eSpark-Consulting-Group/matthewgraff-arduinomegapcb/Design Files/Mega2560_Custom_v2.1/Renderings/3D_Top_View.PNG

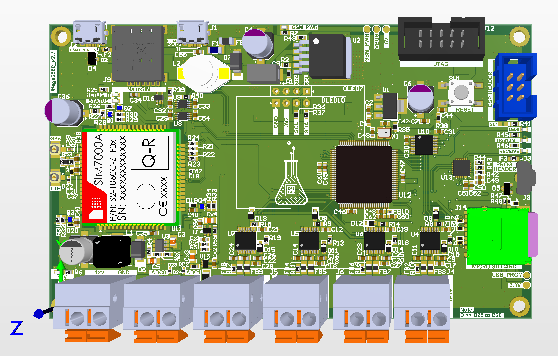
Design Files/Mega2560_Custom_v2.1/Renderings/3D_Top_View.PNG
