eSpark-Consulting-Group/matthewgraff-arduinomegapcb/README.md

# Arduino MEGA 2560 Custom PCB Design
This custom board is a Solar battery powered product that requires some peripherals attached to it to function. The product will be powered via Arduino Framework

The product should be offered as a single SKU, with external antenna for LTE CAT-M1 and GPS/GNSS.

## Requirements
* LCSC parts to be preferred for selection of components
* There will be 3 x MicroUSB inputs to the PCB. First USB input will provide 5V to power the board. Second USB input will be used to program the Arduino MEGA on board and the third USB input will be used to update firmware / debug the SIM7000A.
* One 12V output to power a Wika Pressure Sensor A-10 with GND
* Two analog inputs via screw terminals
* Analog inputs for 4 K-type thermocouples via screw terminals
* Separate antennae for LTE and GNSS
* SIM Card holder (preferably for Nano SIM)
* A screen is also required to display some helpful information to the user. Preference is to choose ILI9341 TFT LCD.
* SD card for logging values
* Reset and other necessary indications for SIMCOM module and MEGA 2560.

## Additional Information
The battery that will be used for input is https://voltaicsystems.com/amp/v75/





## TO DO
1. Design schematic v1 RevA
2. Design PCB v1 RevA
3. Submit deliverables to client for fabrication
