eSpark-Consulting-Group/matthewgraff-arduinomegapcb/Design Files/Mega2560_Custom_v2.1/BOM/Client-BOM.xlsx

 |  | Component list |  | Bill of Materials for Project [Mega2560_Custom]
 |  | Source Data From: |  | Mega2560_Custom
 |  | Project: |  | Mega2560_Custom
 |  | Variant: |  | None
# | Item Type | Designator | Description | Footprint | Manufacturer Part Number | Manufacturer | Value | Quantity | Remarks
1 | Capacitor | C1, C60, C61 | CAP CER 10UF 16V X5R 0603 | Cap-0603 | CC0603KRX5R7BB106 | Yageo | 10uF | 3
2 | Capacitor | C2, C7, C9, C10, C12, C13, C19, C20, C21, C22, C29, C30, C31, C32, C33, C34, C35, C37, C40, C41, C44, C45, C46, C47, C48, C49, C51, C54, C56, Cx1, Cx2 | CAP CER 0.1UF 50V X5R 0603 | Cap-0603 | CC0603KRX5R9BB104 | Yageo | 100nF | 31
3 | Capacitor | C3, C5 | 25V 22uF X5R ±20% 0805 Multilayer Ceramic Capacitors MLCC - SMD/SMT ROHS | Cap-0805 | CS2012X5R226M250NRE | Samwha | 22uF | 2
4 | Capacitor | C4, C6, C36 | CAP ALUM POLY 120UF 20% 20V SMD | Custom | 20SVPF120M | Panasonic | 120uF | 3
5 | Capacitor | C8 | CAP TANT POLY 330UF 6.3V 2917 | Case-D | 6TPB330ML | Panasonic | 330uF | 1
6 | Capacitor | C11, C14, C15, C16, C17, C18, C23, C24, C25, C26, C27, C28 | CAP CER 10000PF 16V X7R 0603 | Cap-0603 | CC0603KRX7R7BB103 | Yageo | 10nF | 12
7 | Capacitor | C38, C55, C62 | CAP CER 1UF 25V X5R 0603 | Cap-0603 | CC0603KRX5R8BB105 | Yageo | 1uF | 3
8 | Capacitor | C39 | CAP CER 33PF 25V C0G/NP0 0402 | Cap-0402 | GRM1555C1E330JA01D | Murata | 33pF | 1
9 | Capacitor | C42, C43 | CAP CER 20PF 50V C0G/NPO 0603 | Cap-0603 | CC0603JRNPO9BN200 | Yageo | 20pF | 2
10 | Capacitor | C50, C52 | CAP CER 4.7UF 16V X5R 0603 | Cap-0603 | CC0603KRX5R7BB475 | Yageo | 4.7uF | 2
11 | Capacitor | C53 | CAP ALUM POLY 47UF 20% 25V SMD | Custom | 25SVPF47M | Panasonic | 47uF | 1
12 | Capacitor | Cx3, Cx4 | CAP CER 2.2UF 50V X5R 0805 | Cap-0805 | CC0805KKX5R9BB225 | Yageo | 2.2uF | 2
13 | Diode | D1, D2, D3, D17, D18 | TVS DIODE 5VWM 6.3VC DSN0603-2 | DSN0603-2 | PESD5V0H1BSFYL | Nexperia | - | 5
14 | Diode | D4, D5 | 16A 20V 7V 5V@Max Unidirectional SOT-23 TVS ROHS | Sot-23 | ESD5302F-3/TR | WILLSEMI | - | 2
15 | Diode | D6 | 0.5mA@40V 40V Single 3A 0.55V@3A SMA(DO-214AC) Schottky Barrier Diodes (SBD) ROHS | SMA | SS34 | MDD | - | 1
16 | Diode | D7 | 20V 500mV@3A 3A SMA(DO-214AC) Schottky Barrier Diodes (SBD) ROHS | SMA | SS32 | MDD | - | 1
17 | Diode | D8, D9, D10, D11, D12, D13, D14, D15 | DIODE GEN PURP 75V 150MA SOD323 | SOD-323 | 1N4148WS-7-F | Diodes | - | 8
18 | Diode | D16 | TVS DIODE 3VWM SOT3235 | SOT-323-5 | ESDA6V1W5 | STMicroelectronics | - | 1
19 | Diode | D19, D20, D21 | 35A@8/20us 15V 4.5V@Max Unidirectional DFN1006 TVS ROHS | DFN1006-2L_ | ESD5651N-2/TR | WILLSEMI(Will Semicon) | - | 3
20 | TVS Diode | D22 | 0402 TVS ROHS | Diode 0402 | LXES15AAA1-153 | Leiditech | - | 1
21 | Diode | D23, D24 | TVS DIODE 12VWM 250VC 0402 | Diode 0402 | PGB1010402KR | Littelfuse | - | 2
22 | Diode | D25, D26, D27, D28, D29 | DFN1006-2L ESD Protection Devices ROHS | DFN1006-2L_ | ESD5451N-2/TR | WILLSEMI | - | 5
23 | Fuse | F1 | PTC RESET FUSE 6V 3A 1206 | Fuse 1206 (3216 Metric) | 1206L300SLTHYR | Littelfuse | - | 1
24 | Fuse | F2, F3 | 6V 500mA 40A 1A 0603 Resettable Fuses ROHS | Fuse-0603 | SMD0603-050 | TECHFUSE | - | 2
25 | Ferrite Bead | FB1 | FERRITE BEAD 120 OHM 1206 1LN | IND-1206 | BLM31PG121SN1L | Murata | 100MHz | 1
26 | Ferrite Bead | FB2, FB3, FB4, FB5, FB6, FB7, FB8, FB9 | FERRITE BEAD 1K OHM 0805 1LN | Ind-0805 | MMZ2012R102ATD25 | TDK | - | 8
27 | Ferrite Bead | FB10 | FERRITE BEAD 120 OHM 0402 1LN | IND-0402 | BLM15PD121SN1D | Murata | - | 1
28 | USB Connector | J1, J2 | CONN RCPT USB2.0 MICRO B SMD R/A | Custom | 10118194-0001LF | Amphenol FCI | - | 2
29 | USB Connector | J3 | CONN RCPT USB2.0 MICRO B SMD | Custom | 105133-0011 | Molex | - | 1
30 | Terminal Block | J4, J5, J6, J7, J11, J15 | TERM BLK 2POS TOP ENT 5.08MM PCB | Custom | HA0200500000G | Amphenol | - | 6
31 | UFL Connector | J8, J10 | CONN U.FL RCPT STR 50 OHM SMD | Custom | U.FL-R-SMT-1(80) | Hirose | - | 2
32 | SIM Card Connectors | J9 | Copper Alloy Self bomb Gold plating 1.25mm Deck -40℃~+85℃ 260℃ NanoSIM SMD SIM Card Connectors ROHS | Custom | XKNANO-113 | XKB Connectivity | - | 1
33 | Connector | J12 | 2.54mm -40℃~+105℃ Straight 3A 250V 5 Push - Pull 2.54mm 2 Plugin,P=2.54mm IDC Connectors ROHS | Custom | BH254V-10P | XFCN | - | 1
34 | Connector | J13 | 2.54mm -40℃~+105℃ Straight 3A 250V 3 Push - Pull 2.54mm 2 Plugin,P=2.54mm IDC Connectors ROHS | Custom | BH254V-6P | XFCN | - | 1
35 | SD Card Connector | J14 | CONN MICRO SD CARD PUSH-PUSH R/A | Custom | DM3BT-DSF-PEJS | Hirose | - | 1
36 | Inductor | L1 | 22uH ±20% SMD Power Inductors ROHS | Custom | SMRH74-220MT | SXN(Shun Xiang Nuo Elec) | - | 1
37 | Inductor | L2 | 2.6A 22uH ±20% 0.085Ω 2.6A SMD,12.95x9.4x5.21mm Power Inductors ROHS | Custom | SSL0804T-220M-N | Chilisin Elec | - | 1
38 | Inductor | L3 | FIXED IND 27NH 590MA 116MOHM SMD | IND-0603 (1608 Metric) | LQW18AN27NG10D | Murata | 27nH | 1
39 | LED | LED1, LED2, LED3 | Red 632nm LED Indication - Discrete 2.05V 0603 (1608 Metric) | LED-0603 | 19-21/R7C-AK1L2BY/3T | Everlight Elec |  | 3
40 | LED | LED4, LED6, LED8, LED9 | Yellow-Green 572nm LED Indication - Discrete 2.05V 0603 (1608 Metric) | LED-0603 | 19-21/G6C-FM1N2B/3T | Everlight Elec |  | 4
41 | OLED Module | OLED7 | ZIO QWIIC 1.5INCH OLED DISPLAY | ZIO-101954 | ZIO-101954 | Smart Prototyping | DNP | 1
42 | OLED Module | OLED10 | 0.96 Inch OLED SSD1306 White/Blue/Yellow 128X64 IIC I2C Serial Display Module 12864 LCD Screen Board For Arduino | OLED 0.96" inch i2C | OLED 0.96" inch i2C | TENSTAR ROBOT | - | 1
43 | TEST POINT | P1, P2, P3, P4, P5, P6 | Test Point ON | - | Test-point | - | - | 6
44 | Mosfet | Q1, Q2, Q3, Q4 | 40V 100mW 100@10mA,1V 200mA 300MHz 300mV@50mA,5mA NPN -55℃~+150℃@(Tj) SOT-723 Bipolar Transistors - BJT ROHS | SOT-723 | MMBT3904M | TECH PUBLIC | - | 4
45 | Resistor | R1 | RES SMD 2.1K OHM 0.1% 1/10W 0603 | Res-0603 | RT0603BRD072K1L | Yageo | 2.1K | 1
46 | Resistor | R2 | RES SMD 1K OHM 0.1% 1/10W 0603 | Res-0603 | RT0603BRD071KL | Yageo | 1K | 1
47 | Resistor | R3, R8, R9, R12, R13, R14, R15, R18, R19, R24, R38, R39, R40, R49 | RES SMD 10K Ohm 1% 1/10W 0603 | Res-0603 | RC0603FR-0710KL | Yageo | 10K | 14
48 | Resistor | R4 | RES SMD 62K OHM 0.1% 1/10W 0603 | Res-0603 | RT0603BRD0762KL | Yageo | 62K | 1
49 | Resistor | R5 | RES SMD 3.16KOHM 0.1% 1/10W 0603 | Res-0603 | RT0603BRD073K16L | Yageo | 3.16K | 1
50 | Resistor | R6, R44 | RES SMD 1.2K OHM 1% 1/10W 0603 | Res-0603 | RC0603FR-071K2L | Yageo | 1.2K | 2
51 | Resistor | R7, R25, R26 | RES 180 OHM 1% 1/10W 0603 | Res-0603 | RC0603FR-07180RL | Yageo | 180R | 3
52 | Resistor | R10, R11, R16, R17 | RES SMD 2K OHM 0.1% 1/10W 0603 | Res-0603 | RT0603BRE072KL | Yageo | 2K | 4
53 | Resistor | R20 | RES SMD 10 OHM 1% 1/10W 0603 | Res-0603 | RC0603FR-0710RL | Yageo | 10R | 1
54 | Resistor | R21, R22, R23 | RES 22 OHM 1% 1/10W 0603 | Res-0603 | RC0603FR-0722RL | Yageo | 22R | 3
55 | Resistor | R27, R29, R31, R33, R36, R37 | RES SMD 4.7K OHM 5% 1/10W 0603 | Res-0603 | RC0603JR-074K7L | Yageo | 4.7K | 6
56 | Resistor | R28, R30, R32, R34 | RES 47K OHM 5% 1/10W 0603 | Res-0603 | RC0603JR-0747KL | Yageo | 47K | 4
57 | Resistor | R35 | RES SMD 1M OHM 1% 1/10W 0603 | Res-0603 | RC0603FR-071ML | Yageo | 1M | 1
58 | Resistor | R41, R45, R46 | RES 470 OHM 1% 1/10W 0603 | Res-0603 | RC0603FR-07470RL | Yageo | 470R | 3
59 | Resistor | R42 | RES 22.1K OHM 1% 1/10W 0603 | Res-0603 | RC0603FR-0722K1L | Yageo | 22.1K | 1
60 | Resistor | R43 | RES 47.5K OHM 1% 1/10W 0603 | Res-0603 | RC0603FR-0747K5L | Yageo | 47.5K | 1
61 | Resistor | R47 | RES 22 OHM 1% 1/16W 0402 | Res-0402 | RC0402FR-0722RL | Yageo | 22 | 1
62 | Resistor | R48 | RES 100K OHM 1% 1/16W 0402 | Res-0402 | RC0402FR-07100KL | Yageo | 100K | 1
63 | Resistor | R50 | ±0.1% 250Ω 1206 Chip Resistor - Surface Mount ROHS | Res-1206 | ARG06BTC2500 | Viking Tech | 250R | 1
64 | Resistor | R51 | RES SMD 3.3K OHM 0.1% 1/10W 0603 | Res-0603 | RT0603BRD073K3L | Yageo | 3.3k | 1
65 | Resistor | R52, R55 | RES SMD 680 OHM 1% 1/10W 0603 | Res-0603 | RC0603FR-07680RL | Yageo | 680R | 2
66 | Resistor | R53 | RES 0 OHM JUMPER 1/10W 0603 | Res-0603 | RC0603JR-070RL | Yageo | 0R | 1
67 | Resistor | R54 | RES SMD 2.2K OHM 0.1% 1/10W 0603 | Res-0603 | RT0603BRB072K2L | Yageo | 2.2K | 1
68 | ~~Solder Bridge~~ | ~~SB1~~ | ~~Solder Bridge ON~~ | ~~Custom~~ | ~~Solder Bridge~~ | ~~-~~ | ~~-~~ | ~~1~~
69 | Switch | SW1 | SWITCH TACTILE SPST-NO 0.05A 12V | Custom | TL3301NF160QG/TR | E-Switch | - | 1
70 | IC | U1 | 15V 1.3V @ 800mA Fixed 3.3V SOT-223 Linear Voltage Regulators (LDO) ROHS | SOT- 223 | AZ1117CH-3.3TRG1 | Diodes Incorporated | - | 1
71 | IC | U2 | IC REG BUCK ADJ 3A TO263-5 | DDPAK | LM2596S-ADJ/NOPB | TI National Semiconductor | - | 1
72 | IC | U3 | boost converterType 1 Boost 28V 2V~24V 1.2MHz SOT-23-6 DC-DC Converters ROHS | SOT-23-6 | MT3608 | XI'AN Aerosemi Tech | - | 1
73 | IC | U4, U5, U6, U7 | IC CONV THERMOCOUPLE 14TSSOP | 14-TSSOP | MAX31856MUD+T | Maxim | - | 4
74 | IC | U8 | IC TRNSLTR BIDIRECTIONAL US8 | VSSOP-8(2x2.3x0.5) | TXB0102DCUT | Texas Instruments | - | 1
75 | IC | U9 | IC TRANSLTR BIDIRECTIONAL 8VSSOP | 8-VSSOP | TXS0102DCUR | Texas Instruments | - | 1
76 | IC | U10 | IC TRANSLATOR BIDIR 14TSSOP | 14-TSSOP | TXB0104PWR | Texas Instruments | - | 1
77 | Module | U11 | eMTC CAT-M1 Module 700MHz/1700MHz/1900MHz 3.8V LCC | Custom | SIM7000A | Simcom | - | 1
78 | IC | U12 | IC MCU 8BIT 256KB FLASH 100TQFP | TQFP-100(14x14) | ATMEGA2560-16AU | Microchip | - | 1
79 | IC | U13 | IC USB TO UART BRIDGE QFN24 | 24-QFN (4x4) | CP2102N-A02-GQFN24R | Silicon Labs | - | 1
80 | IC | U14, U15 | IC OPAMP GP 1 CIRCUIT SC70-5 | SC-70-5 | TLV9301IDCKR | Texas Instruments | - | 2
81 | Crystal | X1 | 16MHz SMD Crystal Resonator 9pF ±10ppm ±30ppm -40℃~+85℃ SMD3225-4P Crystals ROHS | SMD3225-4P | X322516MLB4SI | Yangxing Tech | - | 1
