eSpark-Consulting-Group/matthewgraff-arduinomegapcb/Deliverables/Deliverables v2.0/Supporting_files/Mega2560_Custom-v2.0.step

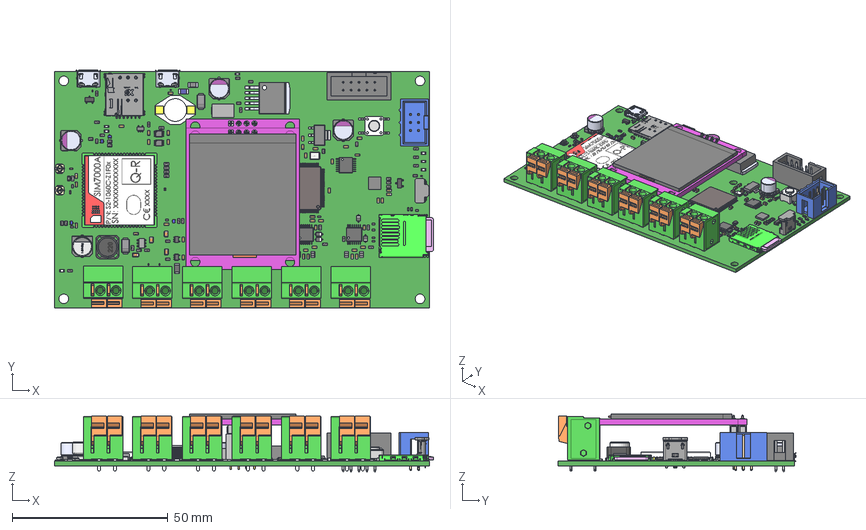
[picture p7: CAD file, 2023-05-11]
Deliverables/Deliverables v2.0/Supporting_files/Mega2560_Custom-v2.0.step
121.8 x 76.6 x 18.5 mm
User_Library-d0402h025
User_Library-CAPC1608X09 x 52
User_Library-SC70-5-1 x 2
User_Library-RESC1608X05N x 51
User_Library-CR3216-1206
eBom-FreeParts x 2
User_Library-0805_SMD_Capacitor x 4
base x 2
cap
pins
logo
u112
HA0200500000G.dwg x 6
User_Library-LED_SMD0603 x 7
User_Library-DO-214AC_SMA x 2
20SVPF120M x 3
User_Library-User_Library-Siward_SX3225
CP2102N-A02-GQFN24R--3DModel-STEP-56544
TQFP_100
_X2_041A043E0440043F04430441_X0_ x 5
_X2_041C04350442043A0430_X0_ x 5
_X2_041D043E0436043A0430_X0_ x 35
TXB0102DCUT
PCA9306DCUR
21-0058I_MXM
NOPB
User_Library-SOT-223-1
TL1105CONTACTDOME
TL3301GBODY
TL1105COVER
TL3301ACTUATOR_N_4_3
User_Library-RES_1005-0402 x 2
VESM x 4
Lötende x 2
Chilisin-Elec-SSL0804T-150M-N_C329870
SXN(Shun_Xiang_Nuo_Elec)_SMRH74-220MT_(2)
CARD
DM3BT
User_Library-Header2x3-shrouded-vertical
Conn_On_Shore_Technology_Inc._302-S101_eec x 11
U.FL-R-SMT-1 x 2
xb-xknano-113_RGB6710886
10118194-0001LF--3DModel-STEP-56544 x 2
BLM31PG121SN1L
0685H9150-01
SOD882_body x 8
SOD882A3_singulated_LF_unit x 8
PESD5V0H1BSF x 7
User_Library-SOT-323-5L
User_Library-SOD323-1 x 8
CircuitWorks-SOT-23 x 2
User_Library-Capacitor_0402
