eSpark-Consulting-Group/matthewgraff-arduinomegapcb/Design Files/Mega2560_Custom_v2.1/Supporting_Files/Mega2560_Custom.step

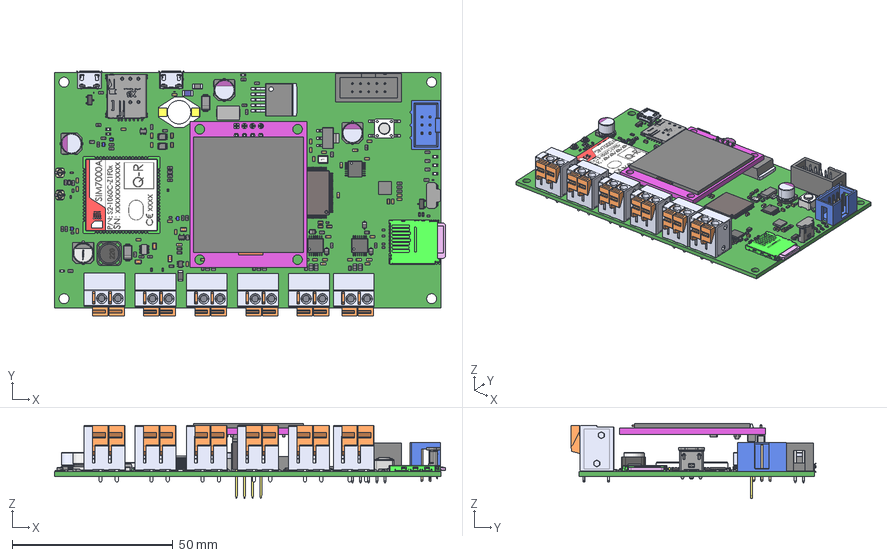
[picture p8: CAD file, 2023-11-01]
Design Files/Mega2560_Custom_v2.1/Supporting_Files/Mega2560_Custom.step
121.8 x 76.4 x 23.4 mm
User Library-RESC1608X05N x 54
User Library-CAPC1608X09 x 53
HA0200500000G.dwg x 6
1x4.step
OLED TFT 0.96 inch 64x128 monochrome.step
eBom-FreeParts
xb-xknano-113_RGB6710886
User Library-d0402h025
User Library-SC70-5-1 x 2
User Library-CR3216-1206
User Library-0805 SMD Capacitor x 4
base x 2
cap
pins
logo
u112
User Library-LED SMD0603 x 7
User Library-DO-214AC SMA x 2
20SVPF120M x 3
User Library-User Library-Siward_SX3225
CP2102N-A02-GQFN24R--3DModel-STEP-56544
TQFP 100
_X2_041A043E0440043F04430441_X0_ x 5
_X2_041C04350442043A0430_X0_ x 5
_X2_041D043E0436043A0430_X0_ x 35
TXB0102DCUT
PCA9306DCUR
21-0058I_MXM
NOPB
User Library-SOT-223-1
TL1105CONTACTDOME
TL3301GBODY
TL1105COVER
TL3301ACTUATOR N 4_3
User Library-RES_1005-0402 x 2
VESM x 4
Lötende x 2
Chilisin-Elec-SSL0804T-150M-N_C329870
SXN(Shun Xiang Nuo Elec) SMRH74-220MT (2)
CARD
DM3BT
User Library-Header2x3-shrouded-vertical
Conn_On_Shore_Technology_Inc._302-S101_eec x 11
U.FL-R-SMT-1 x 2
10118194-0001LF--3DModel-STEP-56544 x 2
BLM31PG121SN1L
0685H9150-01
SOD882 body x 8
SOD882A3 singulated LF unit x 8
PESD5V0H1BSF x 5
User Library-SOT-323-5L
User Library-SOD323-1 x 8
CircuitWorks-SOT-23 x 2
User Library-Capacitor 0402
