eSpark-Consulting-Group/matthewgraff-arduinomegapcb/(list of files, cad)

Other CAD files:
Design Files/Mega2560_Custom_v2.1/Supporting_Files/Mega2560_Custom_v2.1.step
Deliverables/Deliverables v2.0/Supporting_files/Mega2560_Custom-v2.0.DXF
Design Files/Mega2560_Custom_v2.1/Supporting_Files/Mega2560_Custom.DWG
Design Files/Mega2560_Custom_v2.1/Supporting_Files/Mega2560_Custom.DXF
Design Files/Mega2560_Custom_v2.1/Supporting_Files/Mega2560_Custom_v2.1.DXF
