eSpark-Consulting-Group/matthewgraff-arduinomegapcb/Design Files/Mega2560_Custom_v2.1/Schematics/Mega2560_Custom_v2.1.pdf

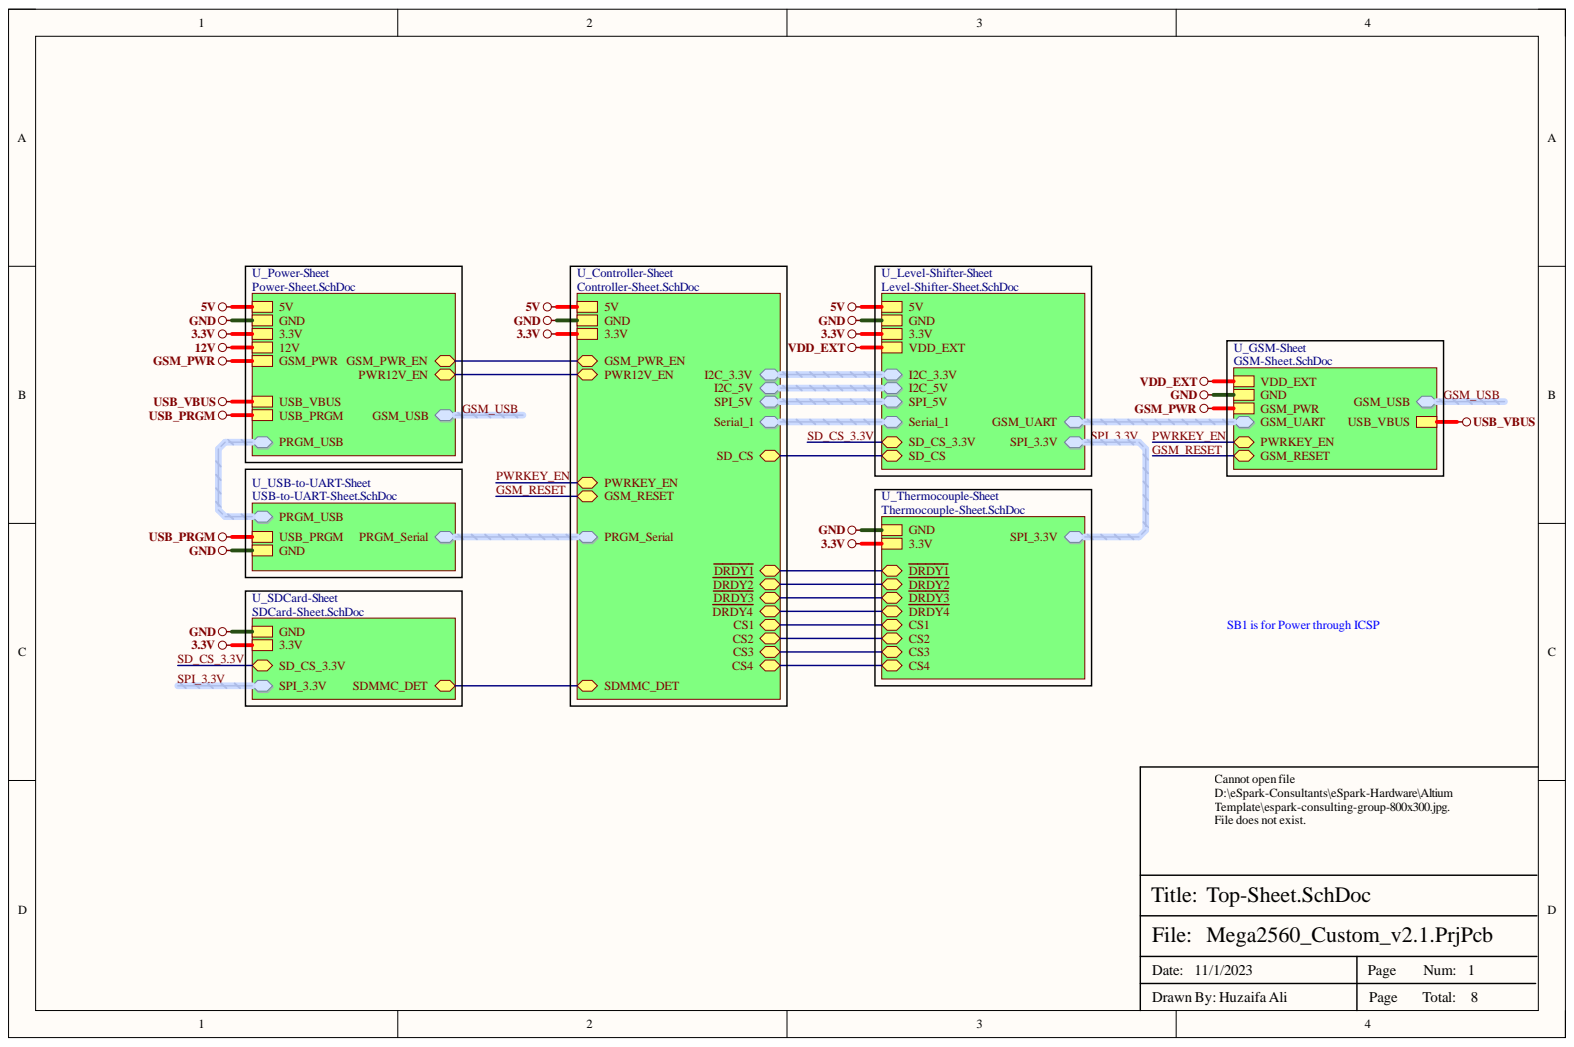
[picture p9: page 1]

SB1 is for Power through ICSP

Cannot open file
D:\eSpark-Consultants\eSpark-Hardware\Altium
Template\espark-consulting-group-800x300.jpg.
File does not exist.

Date: 11/1/2023 | Page Num: 1

Drawn By: Huzaifa Ali | Page Total: 8

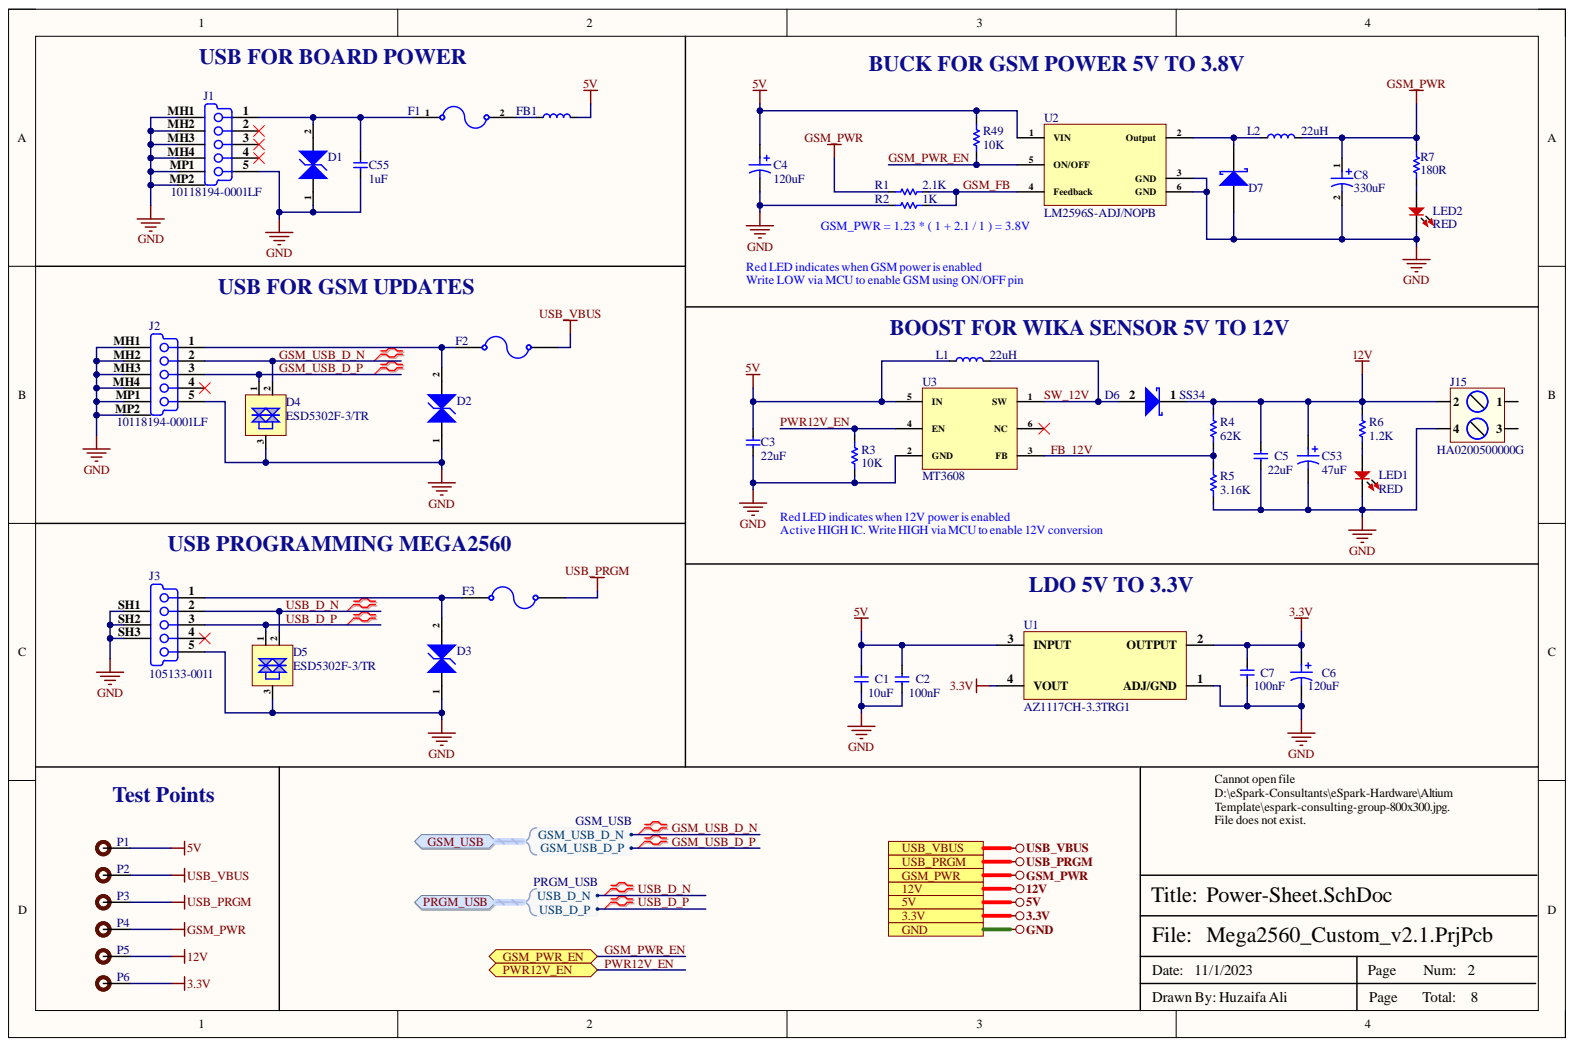
[picture p10: page 2]

USB FOR BOARD POWER

BUCK FOR GSM POWER 5V TO 3.8V

GND
USB FOR GSM UPDATES

Red LED indicates when GSM power is enabled
Write LOW via MCU to enable GSM using ON/OFF pin

BOOST FOR WIKA SENSOR 5V TO 12V

Red LED indicates when 12V power is enabled
Active HIGH IC. Write HIGH via MCU to enable 12V conversion

SH2
SH3

VOUT 4

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

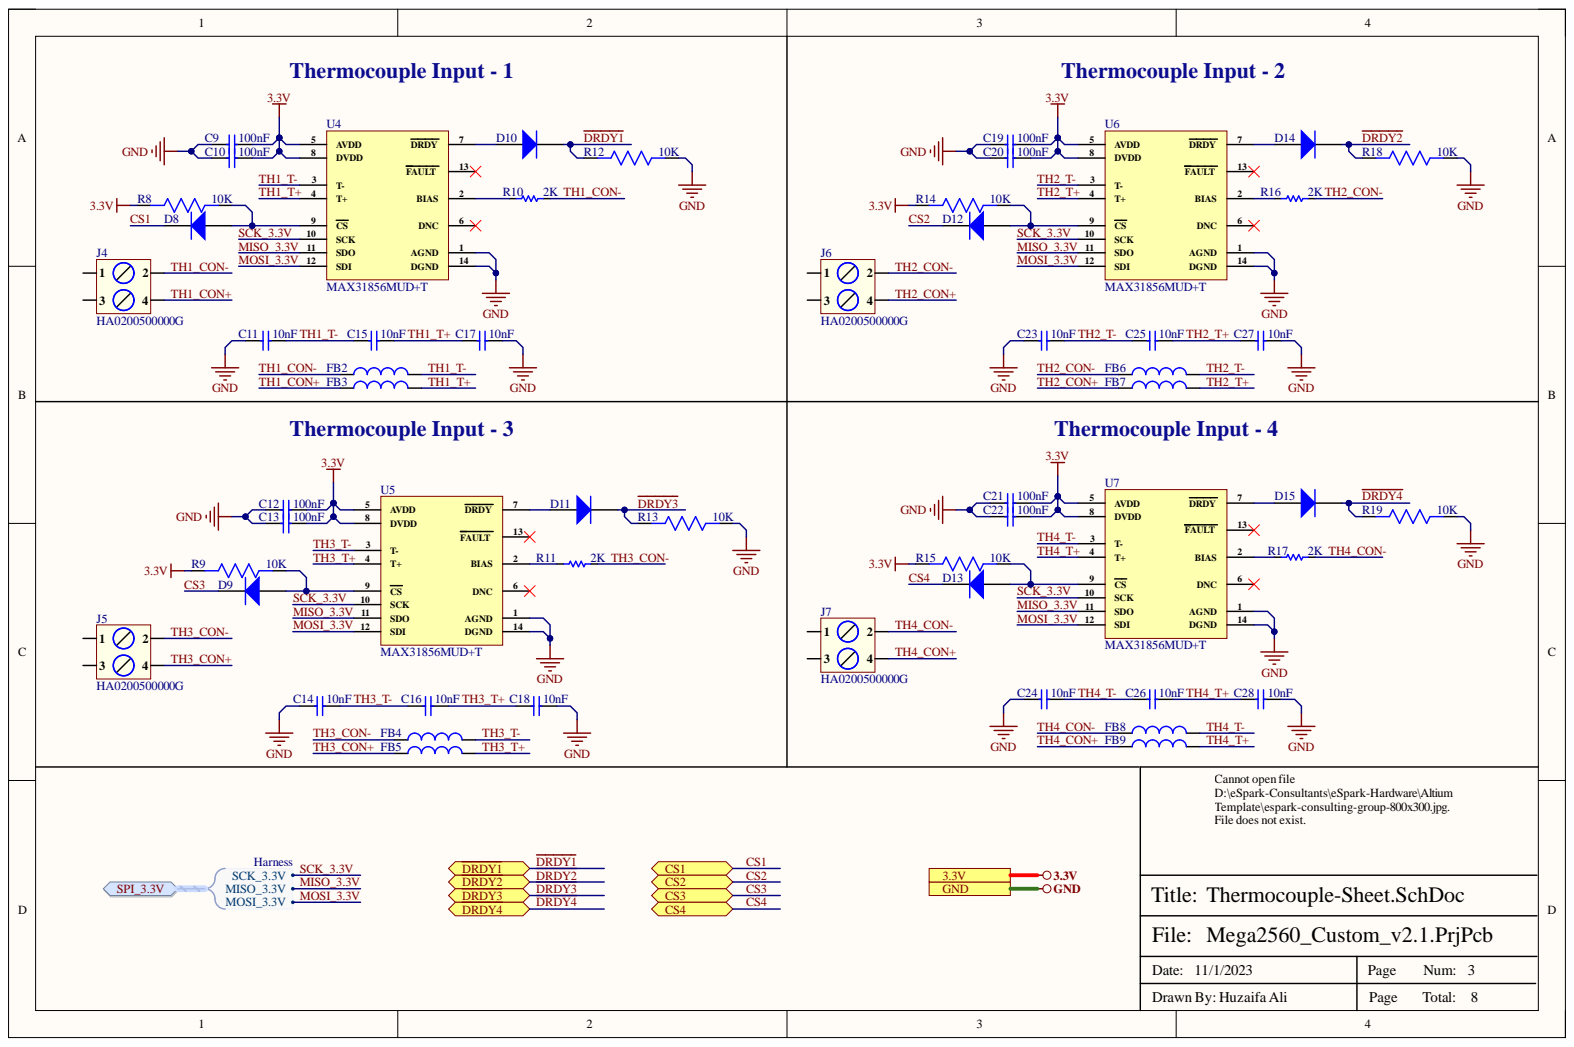
[picture p11: page 3]
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

Date: 11/1/2023 | Page Num: 3

Drawn By: Huzaifa Ali | Page Total: 8

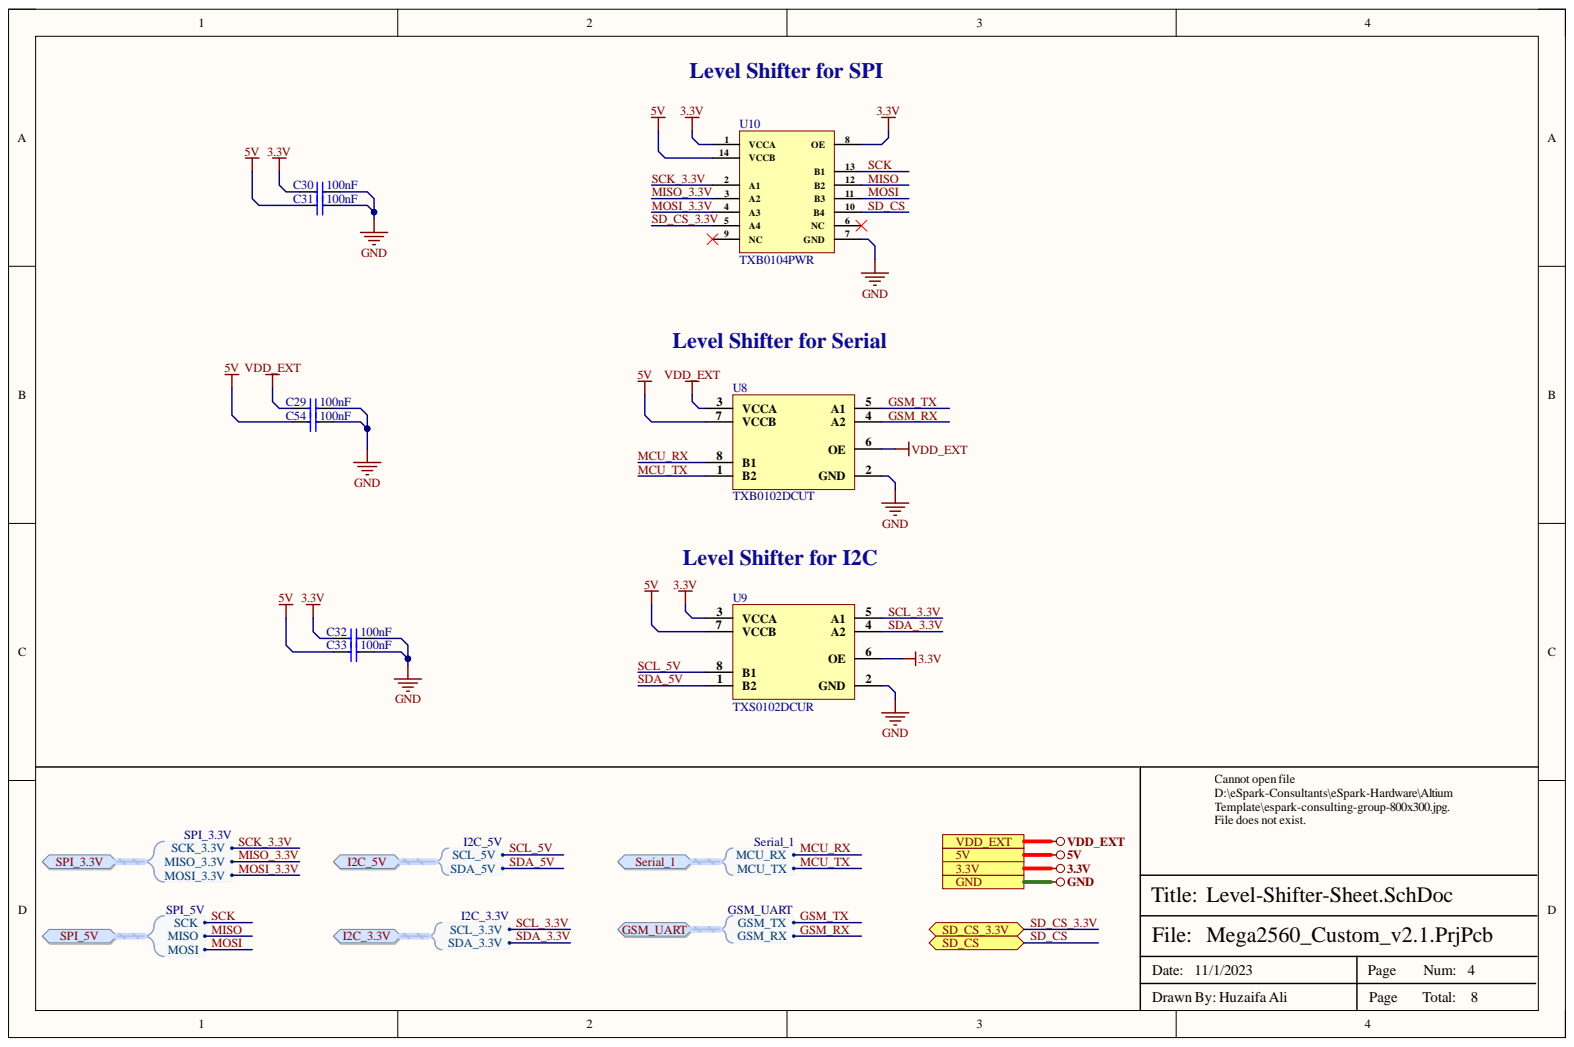
[picture p12: page 4]

Level Shifter for SPI

Level Shifter for Serial

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

Level-Shifter-Sheet.SchDoc

Date: 11/1/2023 | Page Num: 4

Drawn By: Huzaifa Ali | Page Total: 8

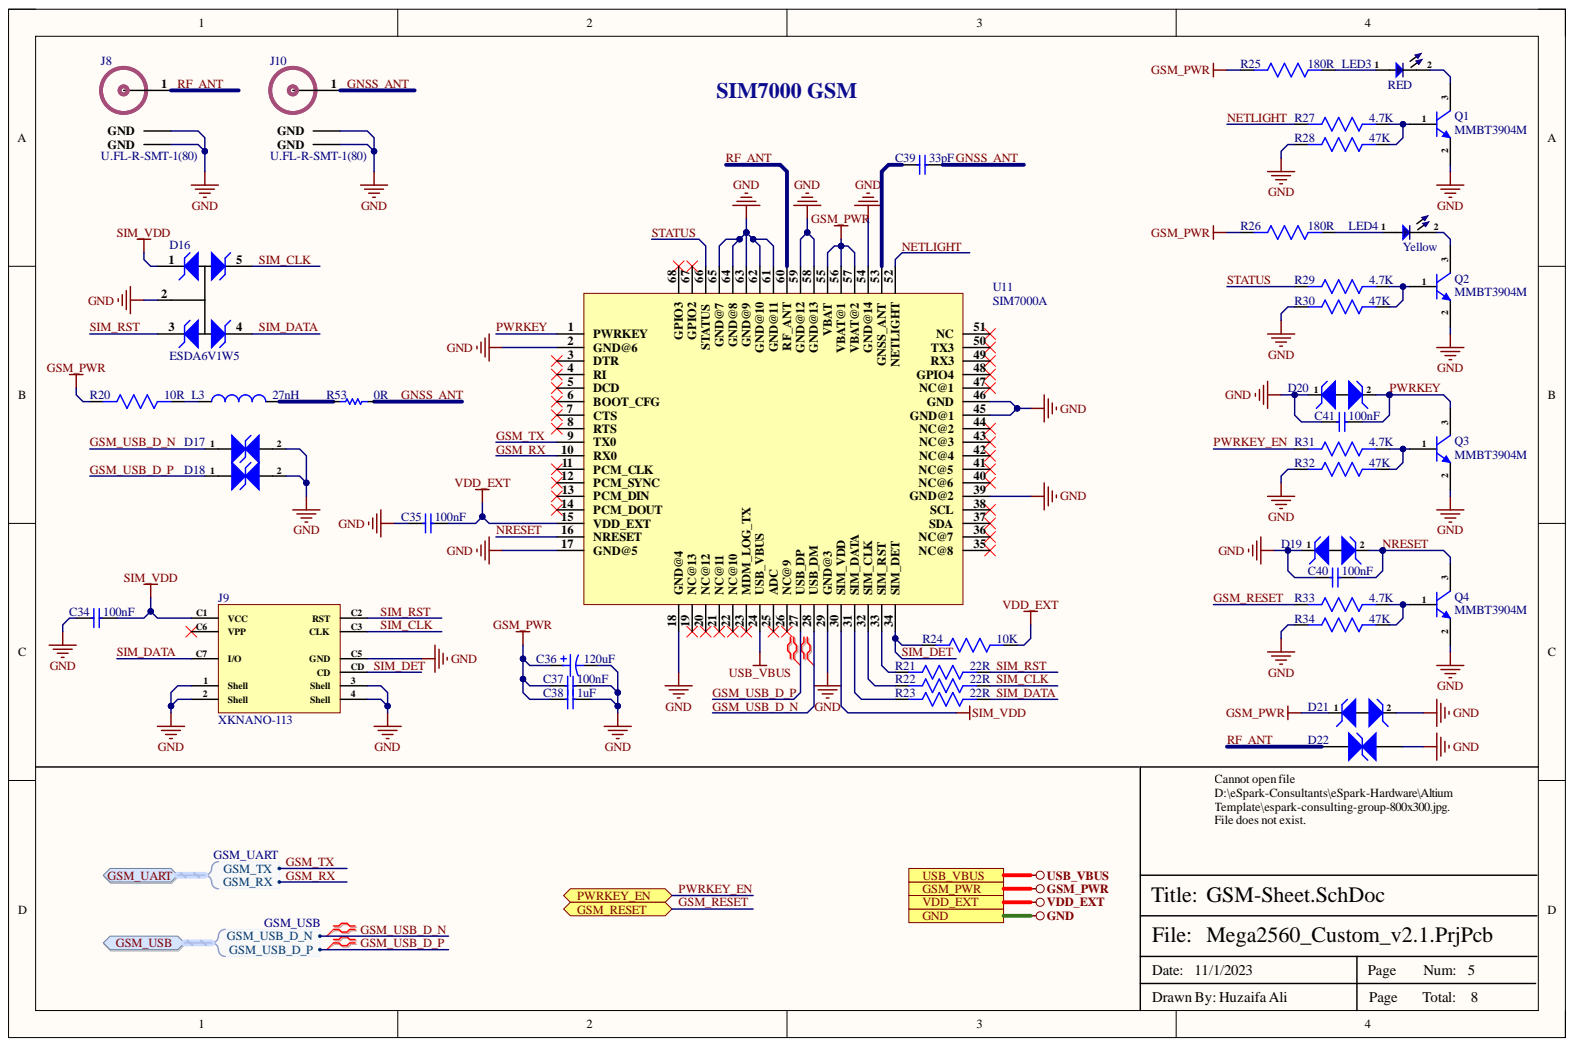
[picture p13: page 5]

USB_VBUS 24 MDM_LOG_TX 23 NC@10 22 NC@11 21 NC@12 20 NC@13 19 GND@4 18

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

Date: 11/1/2023 | Page Num: 5

Drawn By: Huzaifa Ali | Page Total: 8

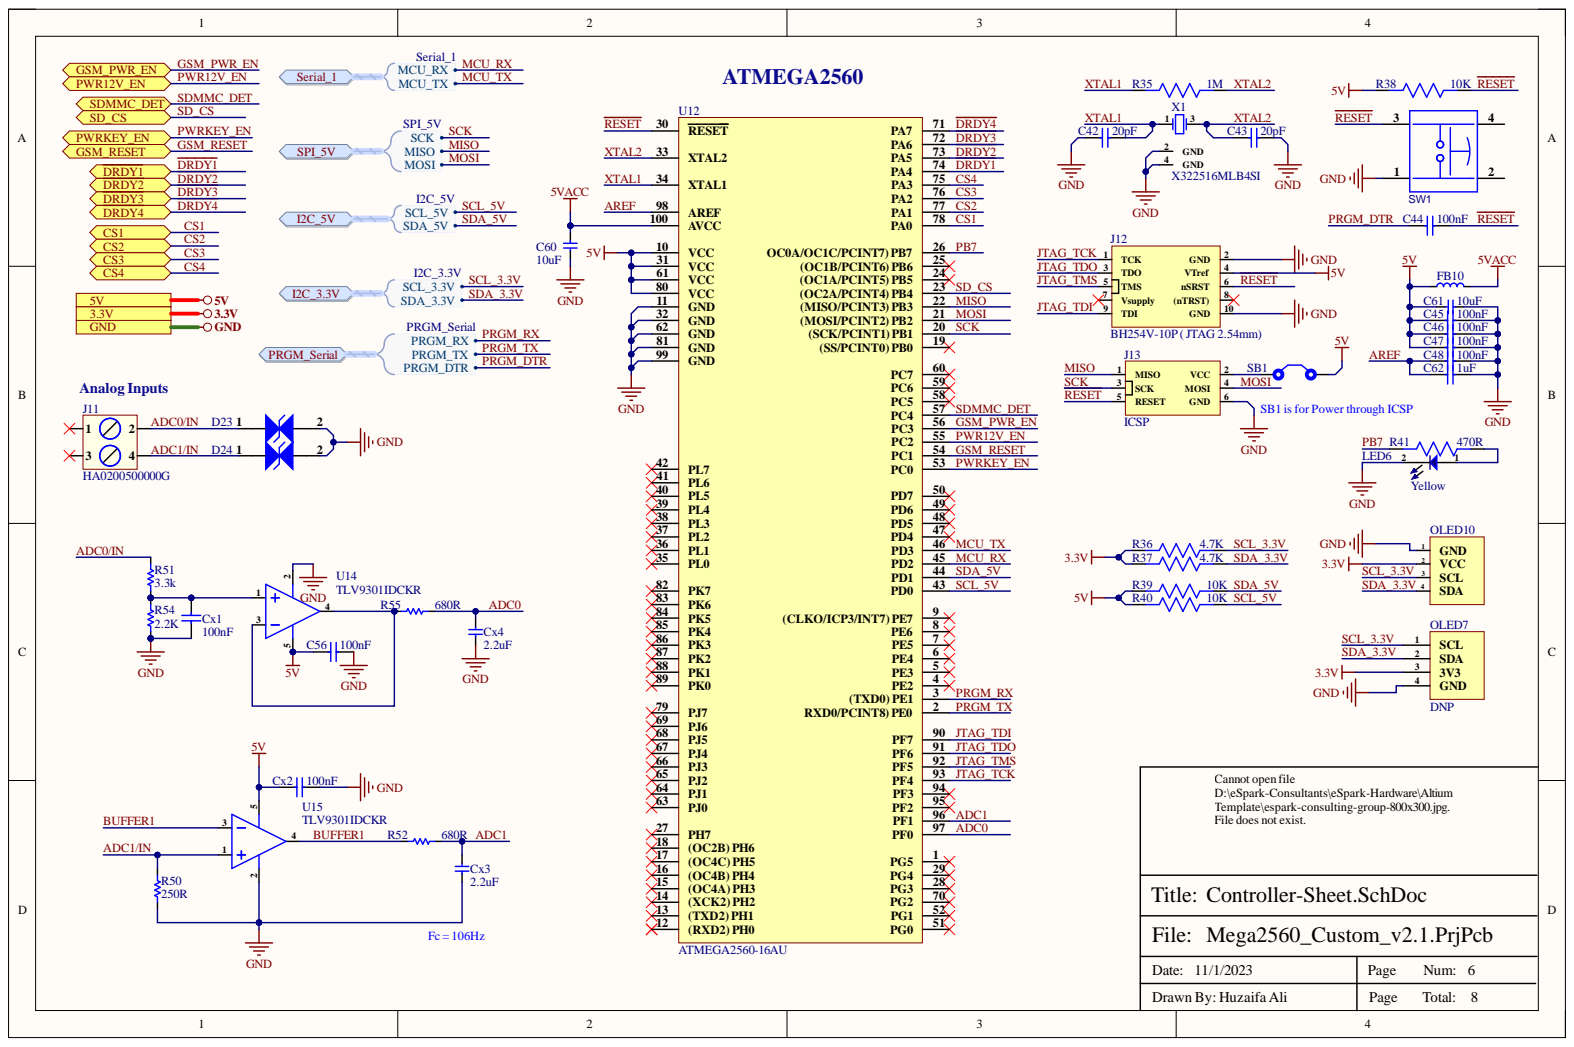
[picture p14: page 6]

Dat e : 1 1 / 1 / 2 0 2 3 | Pag e N u m : 68

D raw n B y : H uzai fa A l i | Pag e To t al :

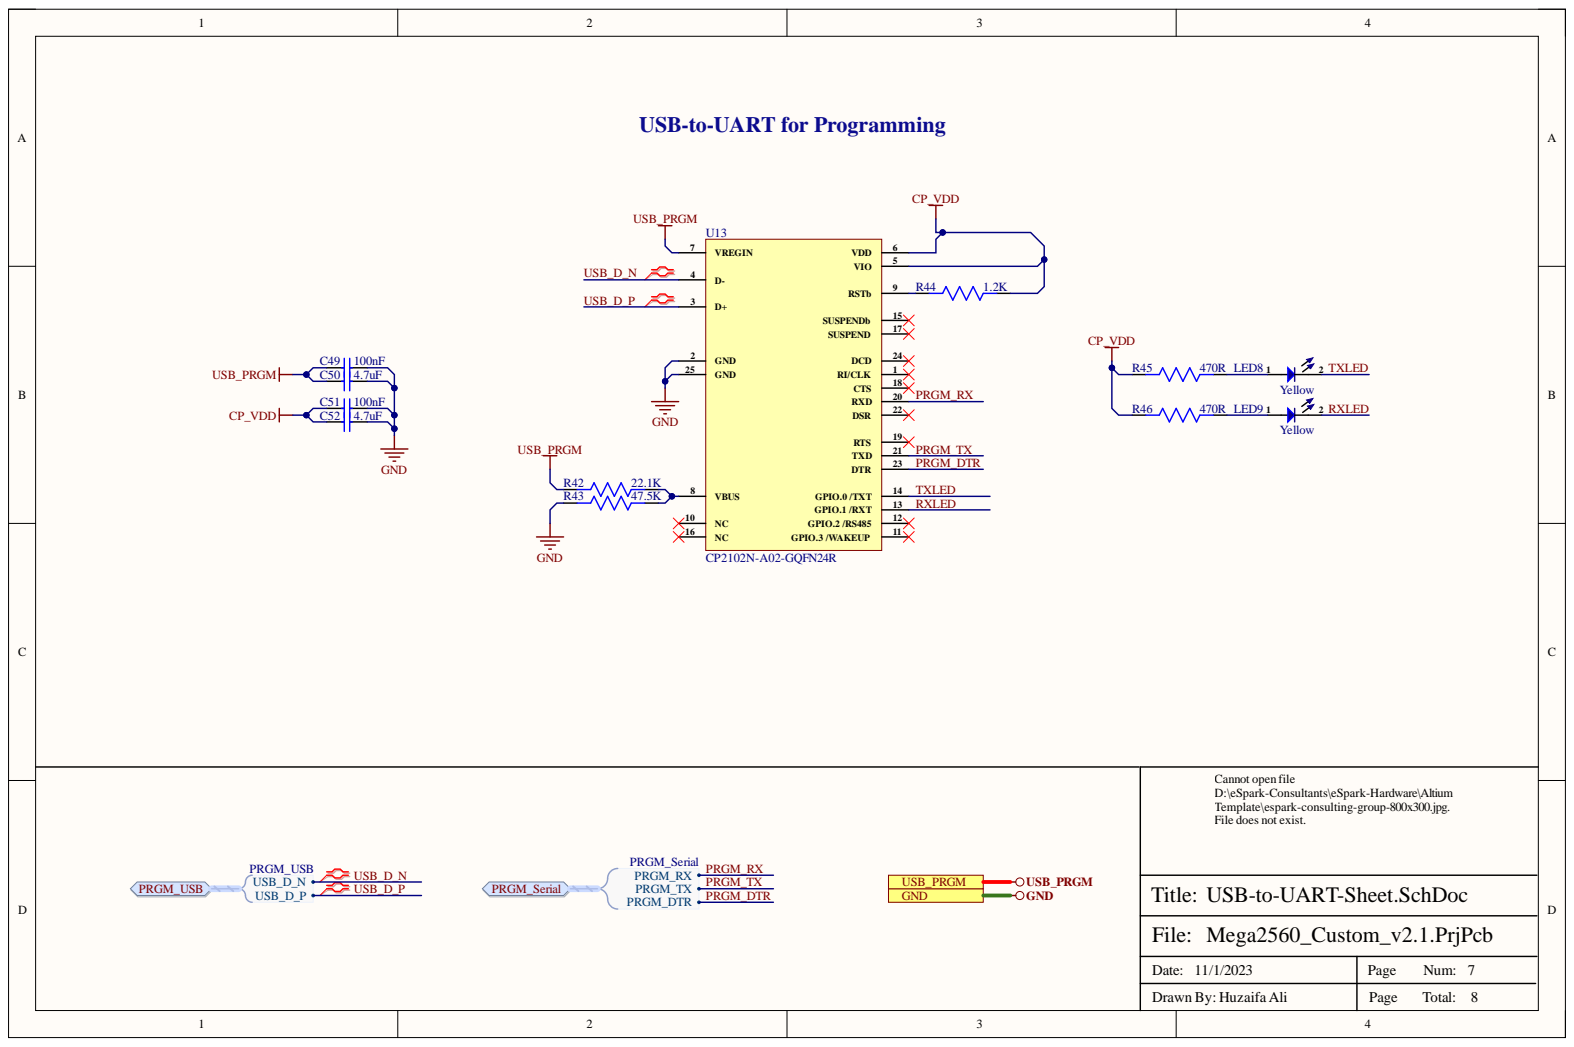
[picture p15: page 7]

USB-to-UART for Programming

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

USB-to-UART-Sheet.SchDoc

Date: 11/1/2023 | Page Num: 7

Drawn By: Huzaifa Ali | Page Total: 8

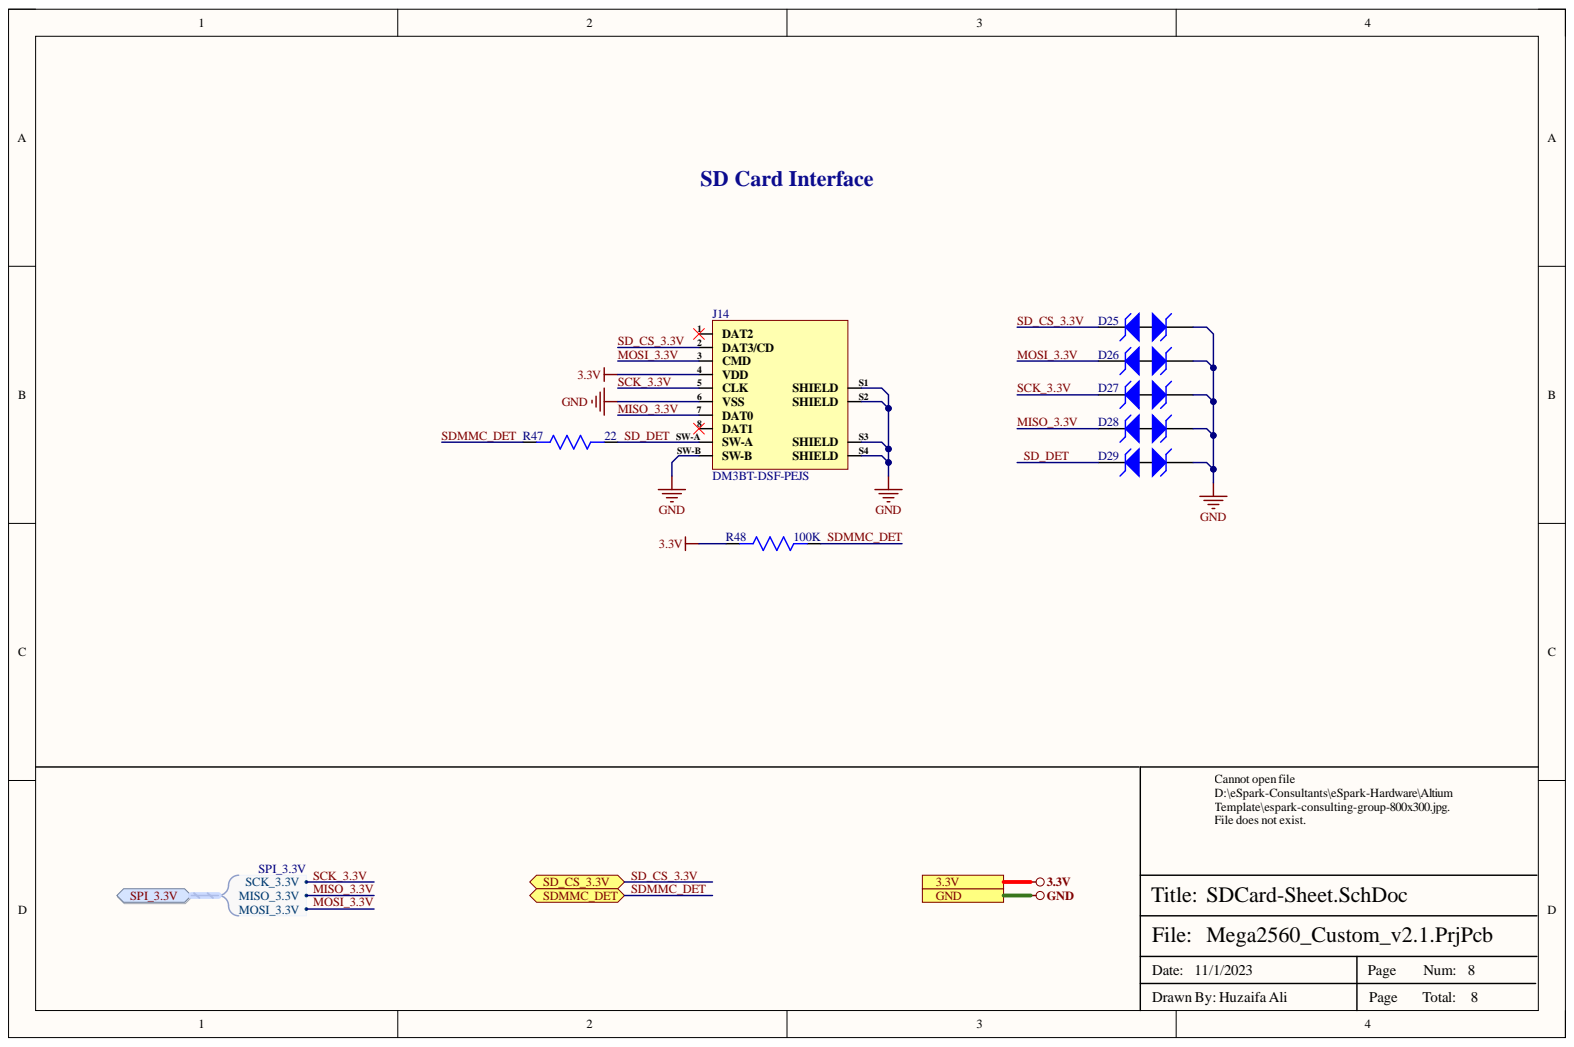
[picture p16: page 8]
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

Date: 11/1/2023 | Page Num: 8

Drawn By: Huzaifa Ali | Page Total: 8

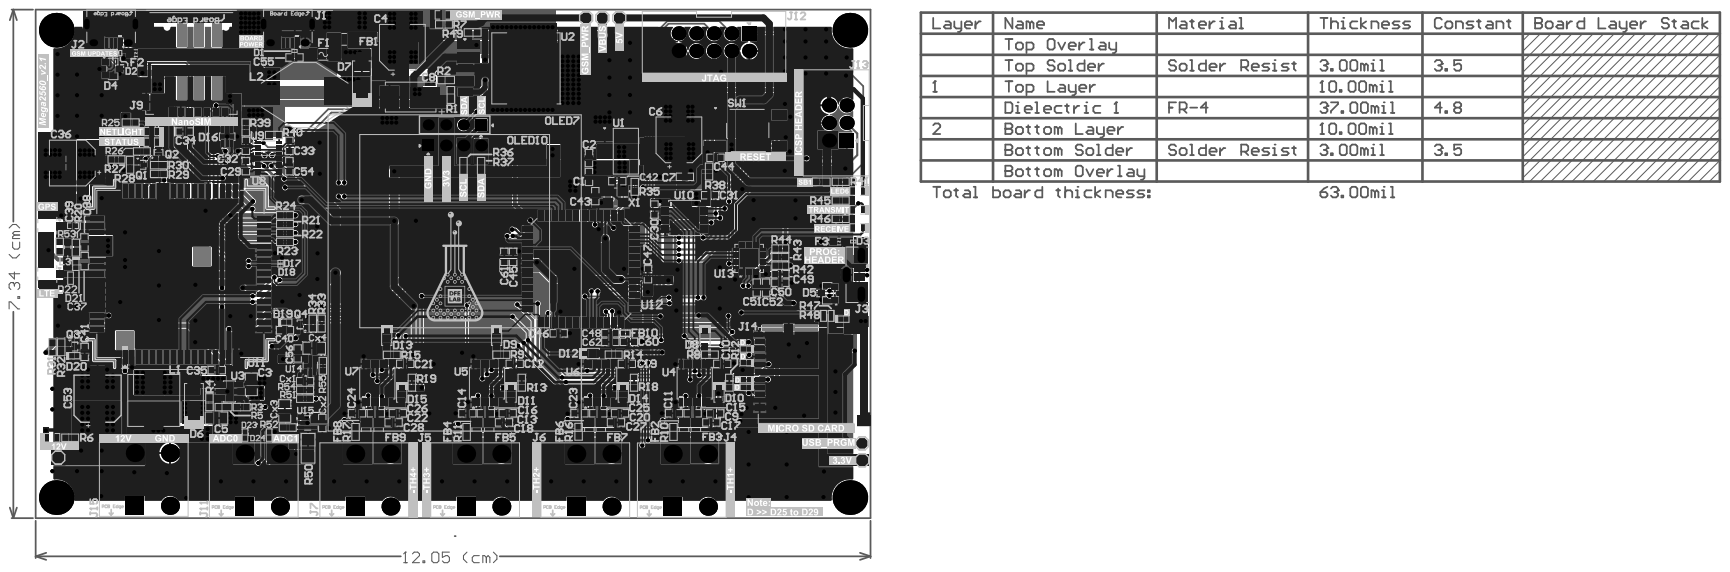
[picture p17: page 9]
