eSpark-Consulting-Group/matthewgraff-arduinomegapcb/Design Files/Mega2560_Custom_v2.1/Schematics/Assembly_Drawing.pdf

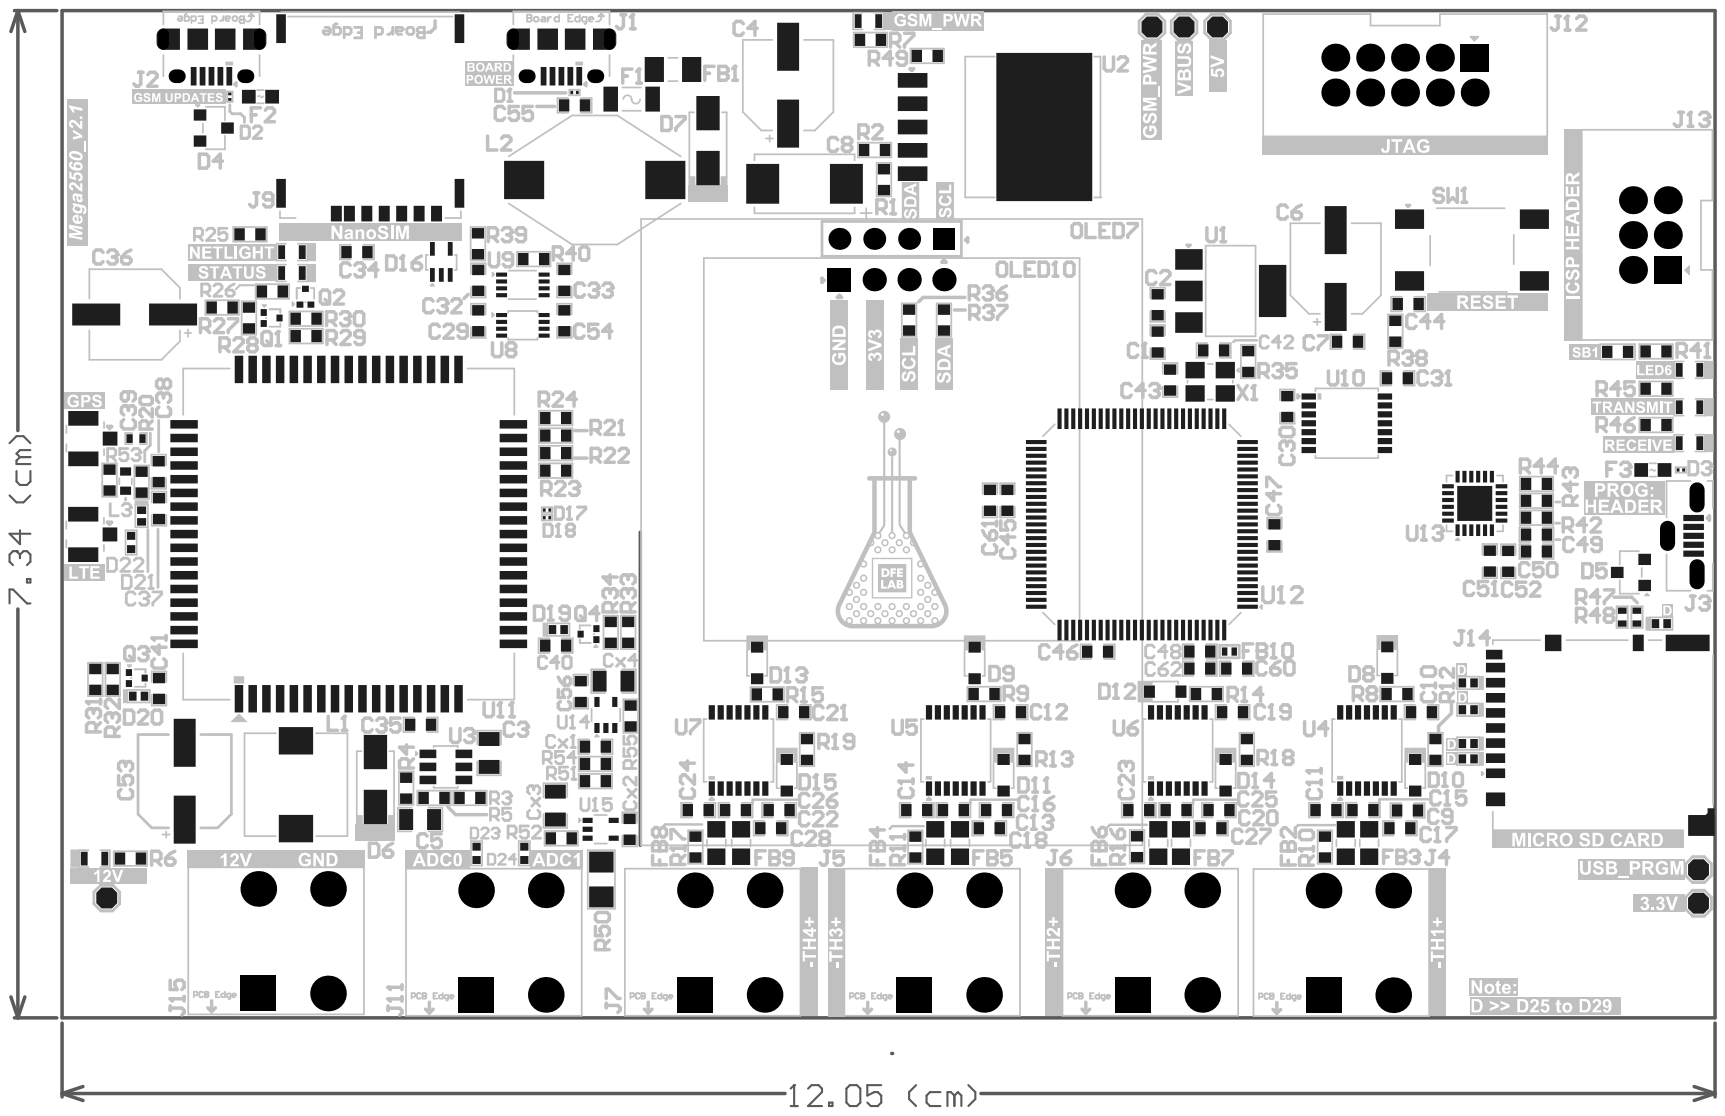
[picture p18: page 1]

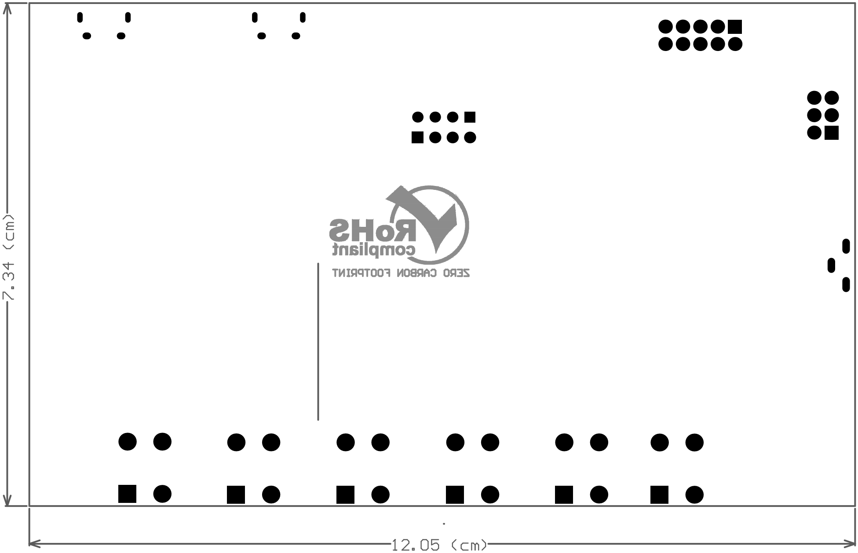
[picture p19: figure]
