eSpark-Consulting-Group/matthewgraff-arduinomegapcb/(list of files, drawings)

Other design files:
Design Files/Mega2560_Custom_v2.1/Controller-Sheet.SchDoc
Design Files/Mega2560_Custom_v2.1/GSM-Sheet.SchDoc
Design Files/Mega2560_Custom_v2.1/Level-Shifter-Sheet.SchDoc
Design Files/Mega2560_Custom_v2.1/Mega2560_Custom.PcbDoc
Design Files/Mega2560_Custom_v2.1/Mega2560_Custom_v2.1.PrjPcb
Design Files/Mega2560_Custom_v2.1/Power-Sheet.SchDoc
Design Files/Mega2560_Custom_v2.1/SDCard-Sheet.SchDoc
Design Files/Mega2560_Custom_v2.1/Thermocouple-Sheet.SchDoc
Design Files/Mega2560_Custom_v2.1/Top-Sheet.SchDoc
Design Files/Mega2560_Custom_v2.1/USB-to-UART-Sheet.SchDoc
