eSpark-Consulting-Group/matthewgraff-arduinomegapcb/(commit log)

2023-01-09 #1 In Progress
    [GSM-Sheet.SchDoc, Level-Shifter-Sheet.SchDoc, Mega2560_Custom.PrjPcb, Power-Sheet.SchDoc, Thermocouple-Sheet.SchDoc]
2023-01-12 #1 Complete
    [Controller-Sheet.SchDoc, GSM-Sheet.SchDoc, Level-Shifter-Sheet.SchDoc, Mega2560_Custom.PcbDoc, Mega2560_Custom.PrjPcb, Power-Sheet.SchDoc, SDCard-Sheet.SchDoc, Thermocouple-Sheet.SchDoc]
2023-01-12 #2 Placement in Progress
    [Mega2560_Custom.PcbDoc]
2023-01-16 #2 PCB parts Placement completed.
    [Controller-Sheet.SchDoc, Level-Shifter-Sheet.SchDoc, Mega2560_Custom.PcbDoc, Power-Sheet.SchDoc, USB-to-UART-Sheet.SchDoc]
2023-01-16 #3 In progress
    [eSpark-BOM.xlsx]
2023-01-17 Routing in Progress
    [Controller-Sheet.SchDoc, GSM-Sheet.SchDoc, Level-Shifter-Sheet.SchDoc, Mega2560_Custom.PcbDoc, Power-Sheet.SchDoc, SDCard-Sheet.SchDoc, Thermocouple-Sheet.SchDoc, Top-Sheet.SchDoc]
2023-01-17 #2 Routing in Progress
    [Mega2560_Custom.PcbDoc]
2023-01-17 #4 USB and Terminal Block changed
    [Controller-Sheet.SchDoc, GSM-Sheet.SchDoc, Level-Shifter-Sheet.SchDoc, Mega2560_Custom.PrjPcb, Power-Sheet.SchDoc, SDCard-Sheet.SchDoc, Thermocouple-Sheet.SchDoc, USB-to-UART-Sheet.SchDoc]
2023-01-18 #2 In-progress.
    [Controller-Sheet.SchDoc, GSM-Sheet.SchDoc, Level-Shifter-Sheet.SchDoc, Mega2560_Custom.PcbDoc, Power-Sheet.SchDoc, SDCard-Sheet.SchDoc, Thermocouple-Sheet.SchDoc, Top-Sheet.SchDoc]
2023-01-19 #3 Completed
    [Client-BOM.xlsx, eSpark-BOM.xlsx]
2023-01-20 #2 Routing completed,
    [Mega2560_Custom.PcbDoc]
2023-01-20 #2 Done.
    [Controller-Sheet.SchDoc, GSM-Sheet.SchDoc, Level-Shifter-Sheet.SchDoc, Mega2560_Custom.PcbDoc, Mega2560_Custom.PrjPcb, Power-Sheet.SchDoc, SDCard-Sheet.SchDoc, Sheet1.SchDoc]
2023-01-20 #7 In-progress.
    [Controller-Sheet.SchDoc, GSM-Sheet.SchDoc, Level-Shifter-Sheet.SchDoc, Mega2560_Custom.PcbDoc, Mega2560_Custom.PrjPcb, Power-Sheet.SchDoc, SDCard-Sheet.SchDoc, Sheet1.SchDoc]
2023-01-22 #7 Done.
    [Controller-Sheet.SchDoc, GSM-Sheet.SchDoc, Level-Shifter-Sheet.SchDoc, Mega2560_Custom.PcbDoc, Mega2560_Custom.PrjPcb, Power-Sheet.SchDoc, SDCard-Sheet.SchDoc, Thermocouple-Sheet.SchDoc]
2023-01-22 #8 Done.
    [Controller-Sheet.SchDoc, GSM-Sheet.SchDoc, Level-Shifter-Sheet.SchDoc, Mega2560_Custom.DWG, Mega2560_Custom.DXF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]
2023-01-23 #8 Updated Files
    [Mega2560_Custom.PrjPcb]
2023-01-25 #9 #3 Updated
    [JLCPCB.xlsx, eSpark-BOM.xlsx]
2023-01-25 #9 Completed
    [Centroid File.csv, Client-BOM.xlsx, JLCPCB.xlsx, eSpark-BOM.xlsx]
2023-01-26 #10 In Progress
    [Controller-Sheet.SchDoc, GSM-Sheet.SchDoc, Level-Shifter-Sheet.SchDoc, Mega2560_Custom.PcbDoc, Mega2560_Custom.PrjPcb, Power-Sheet.SchDoc, SDCard-Sheet.SchDoc, Thermocouple-Sheet.SchDoc]
2023-01-26 #10 In-progress.
    [Controller-Sheet.SchDoc, GSM-Sheet.SchDoc, Level-Shifter-Sheet.SchDoc, Mega2560_Custom.PcbDoc, Mega2560_Custom.PrjPcb, Power-Sheet.SchDoc, SDCard-Sheet.SchDoc, Thermocouple-Sheet.SchDoc]
2023-01-27 #10 Completed ,all components placed on Top layer and done routing accordingly
    [Centroid File.csv, Controller-Sheet.SchDoc, GSM-Sheet.SchDoc, Level-Shifter-Sheet.SchDoc, Mega2560_Custom.DWG, Mega2560_Custom.DWG.DWG, Mega2560_Custom.DXF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]
2023-05-09 added OLED header; solder bridge #15
    [Controller-Sheet.SchDoc, GSM-Sheet.SchDoc, Mega2560_Custom.PrjPcb, Power-Sheet.SchDoc]
2023-05-09 added version number #15
    [Controller-Sheet.SchDoc, GSM-Sheet.SchDoc, Level-Shifter-Sheet.SchDoc, Mega2560_Custom.PcbDoc, Mega2560_Custom_v2.0.PrjPcb, Power-Sheet.SchDoc, SDCard-Sheet.SchDoc, Thermocouple-Sheet.SchDoc]
2023-05-10 #15 Buffer and rc circuit added for ADC1
    [Controller-Sheet.SchDoc, Power-Sheet.SchDoc]
2023-05-10 #15 buffer and rc filter added for ADC0
    [Controller-Sheet.SchDoc]
2023-05-10 #15 Capacitor changed and designators added
    [Controller-Sheet.SchDoc, Mega2560_Custom_v2.0.PrjPcb]
2023-05-10 LED5 (extra OLED removed); NC markings added #15
    [Controller-Sheet.SchDoc]
2023-05-10 PCB updated #15
    [Controller-Sheet.SchDoc, Mega2560_Custom.PcbDoc]
2023-05-10 #15 SCL,SDA pins swapped, ATMEGA IC replaced, and pin protection for ADC added
    [Controller-Sheet.SchDoc]
2023-05-10 #18 eSpark and JLCPCB BOM Addition Completed
    [JLCPCB-BOM.xlsx, eSpark-BOM.xlsx]
2023-05-10 #17 In-progress: PCB Updated: Changes for LED10 and U14 and U15 remaining:
    [Controller-Sheet.SchDoc, GSM-Sheet.SchDoc, Level-Shifter-Sheet.SchDoc, Mega2560_Custom.PcbDoc, Mega2560_Custom_v2.0.PrjPcb, Power-Sheet.SchDoc, SDCard-Sheet.SchDoc, Thermocouple-Sheet.SchDoc]
2023-05-11 Buffer changed; AVCC decoupling and filter added #15
    [Controller-Sheet.SchDoc]
2023-05-11 #18 eSpark and JLCPCB BOM Updated Acc to new Changes
    [JLCPCB-BOM.xlsx, eSpark-BOM.xlsx]
2023-05-11 #17 In-progress: Designator updated for C56 to C59.
    [Controller-Sheet.SchDoc, GSM-Sheet.SchDoc, Level-Shifter-Sheet.SchDoc, Mega2560_Custom.PcbDoc, Power-Sheet.SchDoc, SDCard-Sheet.SchDoc, Thermocouple-Sheet.SchDoc, Top-Sheet.SchDoc]
2023-05-11 #18 2.2uf Capacitor Designator Updated in BOMs
    [JLCPCB-BOM.xlsx, eSpark-BOM.xlsx]
2023-05-11 #17 Done: Changes in PCB Done and Reviewed.
    [Centroid File.csv, Controller-Sheet.SchDoc, GSM-Sheet.SchDoc, Level-Shifter-Sheet.SchDoc, Mega2560_Custom.DWG, Mega2560_Custom.DXF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]
2023-05-11 #20 Done: All deliverables created and updated on Github.
    [Centroid File.csv, Controller-Sheet.SchDoc, GSM-Sheet.SchDoc, Level-Shifter-Sheet.SchDoc, Mega2560_Custom-v2.0.DWG, Mega2560_Custom-v2.0.DXF, Mega2560_Custom-v2.0.step, Mega2560_Custom.DWG]
2023-05-12 #15 Opamp pin changed
    [Controller-Sheet.SchDoc, Mega2560_Custom_v2.0.PrjPcb]
2023-05-12 #17 PCB updated acc to opamp pins corrections #20 fresh deliverables also generated
    [Centroid File.csv, Centroid_File.csv, Mega2560_Custom-v2.0.DWG, Mega2560_Custom.DWG, Mega2560_Custom.DXF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]
2023-05-16 LED header connections flipped #15
    [Controller-Sheet.SchDoc, Mega2560_Custom.PcbDoc, Mega2560_Custom_v2.0.PrjPcb]
2023-05-16 #17 Done: Changes in PCB for LED10 header done.
    [Centroid File.csv, Controller-Sheet.SchDoc, GSM-Sheet.SchDoc, Level-Shifter-Sheet.SchDoc, Mega2560_Custom.DWG, Mega2560_Custom.DXF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]
2023-05-16 #20 Done: Fresh Deliverables generated and updated on Github.
    [Mega2560_Custom_3D.step]
2023-05-17 OLED10 symbol changed #15
    [Controller-Sheet.SchDoc, Mega2560_Custom_v2.0.PrjPcb]
2023-05-17 LED7 connections / symbol updated #15
    [Controller-Sheet.SchDoc]
2023-05-17 #17 Done: Changes in PCB for LED7 header, SIM Connector and Terminal blocks.
    [Controller-Sheet.SchDoc, GSM-Sheet.SchDoc, Level-Shifter-Sheet.SchDoc, Mega2560_Custom.PcbDoc, Mega2560_Custom_v2.0.PrjPcb, Power-Sheet.SchDoc, SDCard-Sheet.SchDoc, Thermocouple-Sheet.SchDoc]
2023-05-18 #18 eSpark, CLient and JLCPCB BOM updated
    [Client-BOM.xlsx, JLCPCB-BOM.xlsx, eSpark-BOM.xlsx]
2023-05-18 #20 Fresh Deliverables generated
    [Centroid File.csv, Centroid.csv, Mega2560_Custom.DWG, Mega2560_Custom.DXF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]
2023-08-01 #22 Required changes done
    [Controller-Sheet.SchDoc, GSM-Sheet.SchDoc, Mega2560_Custom_v2.0.PrjPcb, Top-Sheet.SchDoc]
2023-08-04 #23 Opamp updated
    Opamp updated
    [Controller-Sheet.SchDoc]
2023-08-04 Folders renamed #23
    [Centroid.csv, Controller-Sheet.SchDoc, GSM-Sheet.SchDoc, Level-Shifter-Sheet.SchDoc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]
2023-08-07 #23 SB2 removed
    [USB-to-UART-Sheet.SchDoc]
2023-08-07 #23 D23,D24, R51, R54 replaced
    [Controller-Sheet.SchDoc]
2023-08-07 #23 Client BOM Updated.
    [Client-BOM.xlsx, JLCPCB-BOM.xlsx, eSpark-BOM.xlsx]
2023-08-08 #23 Corrections for Thermocouple IC's remaining: Rest done.
    [Mega2560_Custom.PcbDoc, Mega2560_Custom_v2.1.PrjPcb]
2023-08-09 #23 layout of thermocouple IC updated acc to (eval board)
    [Mega2560_Custom.PcbDoc, Mega2560_Custom_v2.1.PrjPcb, Thermocouple-Sheet.SchDoc]
2023-08-10 #23 Changes in Routing.
    [Mega2560_Custom.PcbDoc, Mega2560_Custom_v2.1.PrjPcb]
2023-08-10 #23 Review Done: Fresh Deliverables generated:
    [Centroid.csv, Centroid_Files.csv, Mega2560_Custom.DWG, Mega2560_Custom.DXF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]
2023-09-13 #23 Designator corrected in PCB. Fresh Gerber, NC Drill and Pick n Place generated.
    [Centroid_File_v2.1.csv, Controller-Sheet.SchDoc, GSM-Sheet.SchDoc, Level-Shifter-Sheet.SchDoc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]
2023-09-13 #23 R10, R11, R16, R17 Resistor part no updated In Client BOM
    [Client-BOM.xlsx]
2023-10-31 #23 HDMI differential pair symbol deleted from sheet.
    [USB-to-UART-Sheet.SchDoc]
2023-10-31 #23 Differential Pair impedance matched closely to 90 Ohms and some minor route changes done.
    [Mega2560_Custom.PcbDoc, Mega2560_Custom_v2.1.PrjPcb]
2023-11-01 #23 Deliverables Generated
    [Centroid_file.csv, Mega2560_Custom.DWG, Mega2560_Custom.DXF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]
